andrewrembrandt/framework-ec-debug-card/production/generic/bom.xls

Item # | *Designator | *Qty | *Mfg Part # | Description / Value | *Package/Footprint | Your Instructions / Notes | Assembly requirement | *Unit Price(1 set) | *Total | *Delivery Time | *Actual Purchase Mfg Part # | *PCBWay Note | Customer Reply | PCBWay Update
1 | C1,C3 | 2 |  | 100nf | Capacitor_SMD:C_0402_1005Metric | ~ |  | $0.306 | $0.612 |  | CGA2B3X7R1H104KT0Y0F
2 | C2 | 1 |  | 4.7uF | Capacitor_SMD:C_0402_1005Metric | ~ |  | $1.076 | $1.076 |  | GRM155R61E475ME15D
3 | C4 | 1 |  | 10nf | Capacitor_SMD:C_0402_1005Metric | ~ |  | $1.428 | $1.428 |  | C1005X7S2A103KT000F
4 | C5,C6 | 2 |  | 47pF | Capacitor_SMD:C_0402_1005Metric | ~ |  | $0.059 | $0.118 |  | TCC0402C0G470J500AT
5 | D1 | 1 |  | KT-0603R | LED_SMD:LED_0603_1608Metric | ~ |  | $0.854 | $0.854 |  | KT-0603R
6 | D2 | 1 |  | KT-0603W | LED_SMD:LED_0603_1608Metric | ~ |  | $0.081 | $0.081 |  | KT-0603W
7 | FB1 | 1 |  | 500mA | Inductor_SMD:L_0402_1005Metric | ~ |  | $0.126 | $0.126 |  | BLM15AX601SN1D
8 | P2 | 1 |  | 2169900001 | FrameworkECDebugCard_v1:MOLEX_2169900001 | https://www.usb.org/sites/default/files/documents/usb_type-c.zip |  | $2.593 | $2.593 | 7-10 Workdays | 2169900001
9 | R1,R2,R3,R6 | 4 |  | 5.1k | Resistor_SMD:R_0402_1005Metric | ~ |  | $0.029 | $0.116 |  | RC0402FR-075K1L
10 | R4,R8 | 2 |  | 270R | Resistor_SMD:R_0402_1005Metric | ~ |  | $0.039 | $0.078 |  | 0402WGF2700TCE
11 | R5,R7 | 2 |  | 27R | Resistor_SMD:R_0402_1005Metric | ~ |  | $0.048 | $0.096 |  | 0402WGF270JTCE
12 | U1 | 1 |  | FT230XS | Package_SO:SSOP-16_3.9x4.9mm_P0.635mm | https://www.ftdichip.com/Support/Documents/DataSheets/ICs/DS_FT230X.pdf |  | $10.666 | $10.666 |  | FT230XS-R
