andrewrembrandt/framework-ec-debug-card/2169900001.step

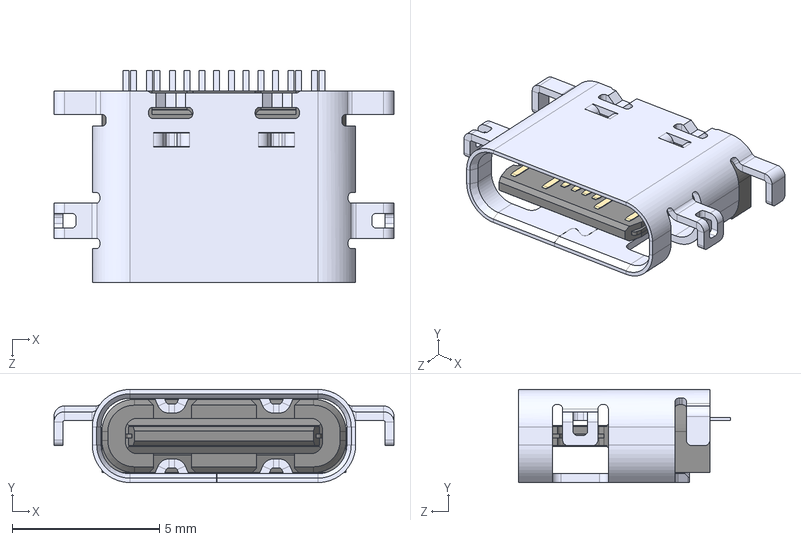
[picture p1: CAD file, 2025-01-27]
2169900001.step
11.5 x 3.16 x 7.20 mm
