andrewrembrandt/framework-ec-debug-card/FrameworkECDebugCard_v1.kicad_pcb

## KiCad design FrameworkECDebugCard_v1.kicad_pcb (2026-03-10)

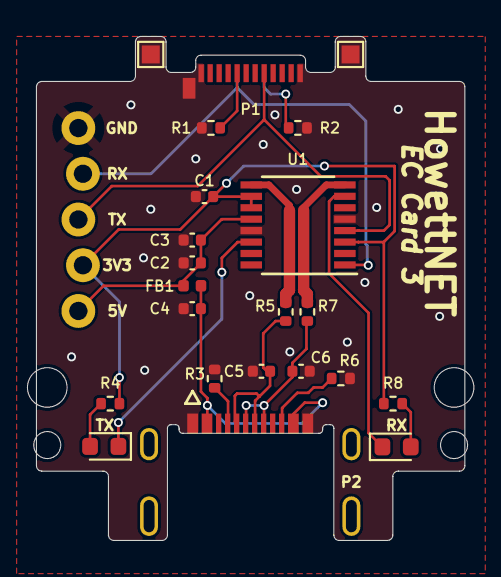
[picture p2: board FrameworkECDebugCard_v1.kicad_pcb from above]

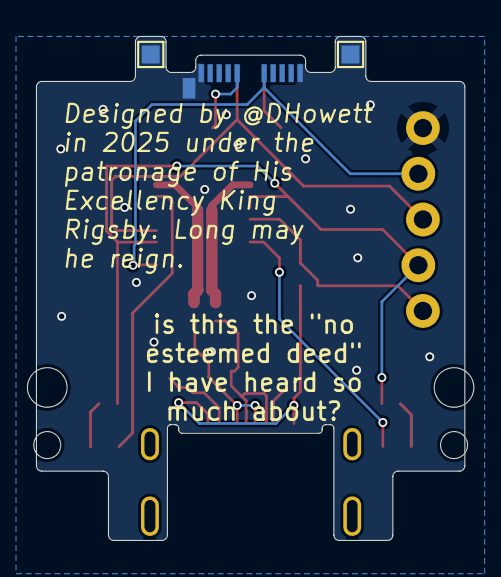
[picture p3: board FrameworkECDebugCard_v1.kicad_pcb from below]

Board: 2 copper layers, 23.8 x 28.0 mm, 29 parts (2 on the bottom side), 19 nets.

Parts:
C1, C3: 100nf; C_0402_1005Metric
C2: 4.7uF; C_0402_1005Metric
C4: 10nf; C_0402_1005Metric
C5, C6: 47pF; C_0402_1005Metric
D1: KT-0603R; LED_0603_1608Metric
D2: KT-0603W; LED_0603_1608Metric
FB1: 500mA; L_0402_1005Metric
H1, H3: MountingHole; MountingHole_2.2mm_M2
H2, H4: MountingHole; MountingHole_1.5mm_NPTH
J1: Conn_01x05; 1X05_LOCK
P1: 1054440011; USB_C_Plug_Molex_105444_SmallPads
P2: 2169900001; MOLEX_2169900001
R1, R2, R3, R6: 5.1k; R_0402_1005Metric
R4, R8: 270R; R_0402_1005Metric
R5, R7: 27R; R_0402_1005Metric
TP1, TP2, TP3, TP4: TestPoint; TestPoint_Pad_1.0x1.0mm
U1: FT230XS; SSOP-16_3.9x4.9mm_P0.635mm

Connections:
/DIN: J1.4, P1.B8 (DIN), U1.1 (TXD)
/DOUT: J1.3, P1.A8 (DOUT), U1.4 (RXD)
/F_USBD+: R7.2, U1.8 (USBDP)
/F_USBD-: R5.2, U1.9 (USBDM)
/RXLED: D2.1 (K), U1.7 (CBUS2)
/TXLED: D1.1 (K), U1.14 (CBUS1)
/USBD+: C6.1, P2.A6 (D+), P2.B6 (D+), R7.1
/USBD-: C5.1, P2.A7 (D-), P2.B7 (D-), R5.1
GND: C1.2, C2.2, C3.2, C4.2, C5.2, C6.2, J1.5, P1.A1 (GND), P1.A12 (GND), P1.B1 (GND), P1.B12 (GND), P1.S1 (SHIELD), P2.A1 (GND), P2.A12 (GND), R1.2, R2.2, R3.1, R6.1, TP1.1, TP2.1, TP3.1, TP4.1, U1.5 (GND), U1.13 (GND)
unnamed: C4.1, FB1.1, P2.A4 (VBUS), P2.A9 (VBUS)
unnamed: D1.2 (A), R4.2
unnamed: D2.2 (A), R8.2
unnamed: P1.A5 (CC), R1.1
unnamed: P1.A4 (VBUS), P1.A9 (VBUS), P1.B4 (VBUS), P1.B9 (VBUS)
unnamed: P1.B5 (VCONN), R2.1
unnamed: P2.A5 (CC1), R3.2
unnamed: P2.B5 (CC2), R6.2
VBUS_HOST: C2.1, C3.1, FB1.2, J1.1, U1.12 (VCC)
VCCIO: C1.1, J1.2, R4.1, R8.1, U1.3 (VCCIO), U1.10 (3V3OUT), U1.11 (~RESET)
