andrewrembrandt/framework-ec-debug-card/(commit log)

2022-07-10 Add the first rev of the card:
    Uses FT230XS and 0603 components.
    [FrameworkECDebugCard_v1.kicad_pcb, FrameworkECDebugCard_v1.kicad_sch, FrameworkECDebugCard_v1.sch]
2022-07-10 v1.1: switch to FT230XQ (QFN) and 0402 components instead of 0603
    [FrameworkECDebugCard_v1.kicad_pcb, FrameworkECDebugCard_v1.kicad_sch]
2022-07-10 Schematic: clarify VBUS_{HOST,DEV}, reorganize to avoid flyover wires
    [FrameworkECDebugCard_v1.kicad_pcb, FrameworkECDebugCard_v1.kicad_sch]
2022-07-12 Rework board per Kieran's suggestions
    - Route the USB differential pairs together, and without vias
    - Had to move back to the SSOP package because the QFN package
    would require a crossover (yes, no, it doesn't make any sense)
    - Ground fill
    - Hand-route
    - Redistribute passives to be more reasonably laid out
    - Power the FTDI chip off VBUS_HOST instead of VBUS_DEV
    - Add TX/RX LEDs
    - Add a ferrite bead
    [FrameworkECDebugCard_v1.kicad_pcb, FrameworkECDebugCard_v1.kicad_sch]
2022-07-12 Add a 1x5 header to break out the EC/FTDI pins
    This header uses the SparkFun "LOCK" footprint, which should
    allow me to click in a header without soldering it down.
    [FrameworkECDebugCard_v1.kicad_pcb, FrameworkECDebugCard_v1.kicad_sch]
2022-07-12 Re-route the USB differential pairs following the DigiKey guide
    These traces are *C H O N K Y*
    [FrameworkECDebugCard_v1.kicad_pcb]
2022-07-14 Move the passives closer to USB, use 6mil traces to passives
    [FrameworkECDebugCard_v1.kicad_pcb]
2022-07-14 Re-route VCCIO to move cap closer to 3V3OUT, reroute RXLED in the new space
    [FrameworkECDebugCard_v1.kicad_pcb]
2022-07-14 Re-route everything to avoid B.Cu cuts across diff pair
    Switched the positions of the TX and RX LEDs to match which side of the
    chip they're on. Significantly re-routed TX/RX. Added via stitching.
    The ground planes are much more contiguous, except for U1 pad 5 which
    connects to GND on the back with a via.
    (Kieran's suggestion was to remove the lines on the back that cut
    horizontally across the differential pair; I don't know if having
    RXLED's sink next to the diff pair will be a problem.)
    Re-version the card to "EC Card 2"
    [FrameworkECDebugCard_v1.kicad_pcb, FrameworkECDebugCard_v1.kicad_sch]
2022-07-16 Add more stitching vias
    [FrameworkECDebugCard_v1.kicad_pcb]
2025-01-20 Update to KiCad 8, use narrower pads on USB C plug (PCBWay may mfg this)
    [FrameworkECDebugCard_v1.kicad_pcb]
2025-01-21 sch: update to kicad 8
    [FrameworkECDebugCard_v1.kicad_sch]
2025-01-23 ec card 3: recessed mid-mount usb c receptacle, fully rerouted
    [FrameworkECDebugCard_v1.kicad_pcb, FrameworkECDebugCard_v1.kicad_sch]
2025-01-23 ec3: rebuild the pcb to the same shape as the usb c card; not routed
    [FrameworkECDebugCard_v1.kicad_pcb, FrameworkECDebugCard_v1.kicad_sch]
2025-01-25 ec3: route it! use JLCPCB's tolerances
    [FrameworkECDebugCard_v1.kicad_pcb, FrameworkECDebugCard_v1.kicad_sch]
2025-01-27 ec3: length-match the D+/- pair, move logo
    [FrameworkECDebugCard_v1.kicad_pcb]
2025-01-27 ec3: switch to 'real' molex footprint
    [2169900001.step, FrameworkECDebugCard_v1.kicad_pcb, FrameworkECDebugCard_v1.kicad_sch]
2025-01-27 ec3: branding! fun! whimsy!
    [FrameworkECDebugCard_v1.kicad_pcb]
2025-01-27 ec3: specify LEDs, some pad types
    [FrameworkECDebugCard_v1.kicad_pcb, FrameworkECDebugCard_v1.kicad_sch]
2025-01-27 ec3: remove empty accidental footprint
    [FrameworkECDebugCard_v1.kicad_pcb]
2025-01-27 ec3: drc moved a bunch of things around by fractional mm
    [FrameworkECDebugCard_v1.kicad_pcb]
2025-01-27 ec3: geographical reannotate
    [FrameworkECDebugCard_v1.kicad_pcb, FrameworkECDebugCard_v1.kicad_sch]
2025-01-27 ec3: ground the USB C receptacle shields; no thermal spokes
    [FrameworkECDebugCard_v1.kicad_pcb]
2025-01-27 ec3: fix typo
    [FrameworkECDebugCard_v1.kicad_pcb]
2026-03-02 Remove legacy KiCad v5 files
    [FrameworkECDebugCard_v1.sch]
2026-03-02 Upgrade to KiCad 9
    [FrameworkECDebugCard_v1.kicad_pcb, FrameworkECDebugCard_v1.kicad_sch]
2026-03-03 Add JLCPCB LCSC part numbers
    [FrameworkECDebugCard_v1.kicad_pcb, FrameworkECDebugCard_v1.kicad_sch]
2026-03-03 Fabrication files export settings (PCBWay etc)
    [FrameworkECDebugCard_v1.kicad_pcb, FrameworkECDebugCard_v1.kicad_sch]
2026-03-09 Remove vias-in-pad
    [FrameworkECDebugCard_v1.kicad_pcb]
2026-03-09 Add PCBWay design rules
2026-03-09 Remove P1 from bom and tune Fabrication settings for PCBWay
    [FrameworkECDebugCard_v1.kicad_pcb, FrameworkECDebugCard_v1.kicad_sch]
2026-03-09 Add manual BOM
    [bom.xls]
2026-03-10 Exclude P2 from PCBWay/JLCPCB assembly (cheaper to do it manually)
    [FrameworkECDebugCard_v1.kicad_pcb, FrameworkECDebugCard_v1.kicad_sch]
