andrewrembrandt/framework-ec-debug-card/(notices)

Notices in the files:
FrameworkECDebugCard_v1.kicad_sch:
This work is licensed under a Creative Commons Attribution 4.0 International License
